Nobcha/ArduinoLCM/Equation＋Circuit.docx

Calibration

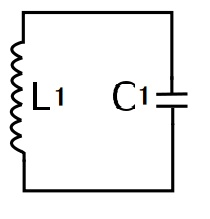
[picture p2: figure]
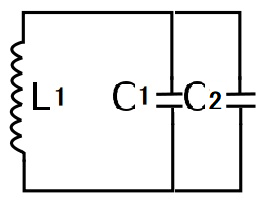
[picture p3: figure]

ｆ１ f2

ｆ1＝1/(, 2π√(Ｌ１・Ｃ１),)

ｆ2＝1/(, 2π√(Ｌ１・（Ｃ１＋Ｃ２）),)

C2：Standard　capacitor、 f1，f2:Measurement value　　　To derive C1 &　L1

Measurement

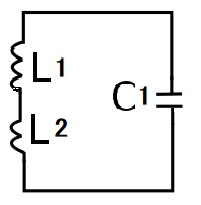
[picture p4: figure]
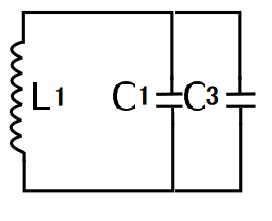
[picture p5: figure]

ｆ31 f32

ｆ31＝1/(, 2π√(Ｌ１・（Ｃ１＋Ｃ3）),) 　　　　　　　　　　ｆ32 ＝1/(, 2π√(（Ｌ１＋Ｌ２）・Ｃ１),)
