Nobcha/ArduinoLCM/equation.pdf

## 1. Calibration

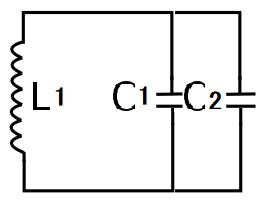
[picture p6: figure]
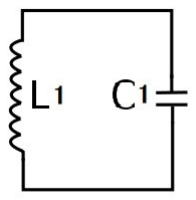
[picture p7: figure]

The basic LC circuit | When calibration, the standard capacitor added.
ｆ１ | f2

ｆ1＝

Ｌ１・Ｃ１

ｆ2＝

Ｌ１・（Ｃ１＋Ｃ２）

C2：Standard capacitor （Precise）、 f1，f2:Measurement value To derive C1 & L1
We got two formulas from above calibration. To solve the simultaneous equations, we get C1 and L1 from C2, f1 and f2.

C1＝

f2∗∗2
(f1∗∗２−f2∗∗２)
C2 | L1＝
ｆ１∗∗２・
After then we will use C1 and L1. They are involved stray capacitance and inductance.

## 2. Measurement

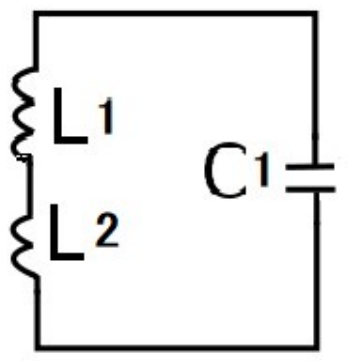
[picture p8: figure]

ｆ31＝ | 1
2πＬ１＋Ｌ２・Ｃ１

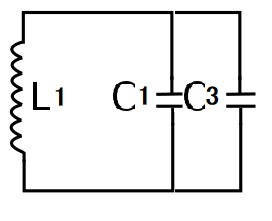
[picture p9: figure]

32 1
2π | 3

The known L1 and C1 and measured f31 and f32 will lead tested L2 and C3 value. L2＝
ｆ1∗∗2
ｆ31∗∗2
− 1・L1 | C3＝
ｆ1∗∗2
ｆ32∗∗2

− 1・C1
