Nobcha/ArduinoLCM/2022-09-08 CASE.jpg

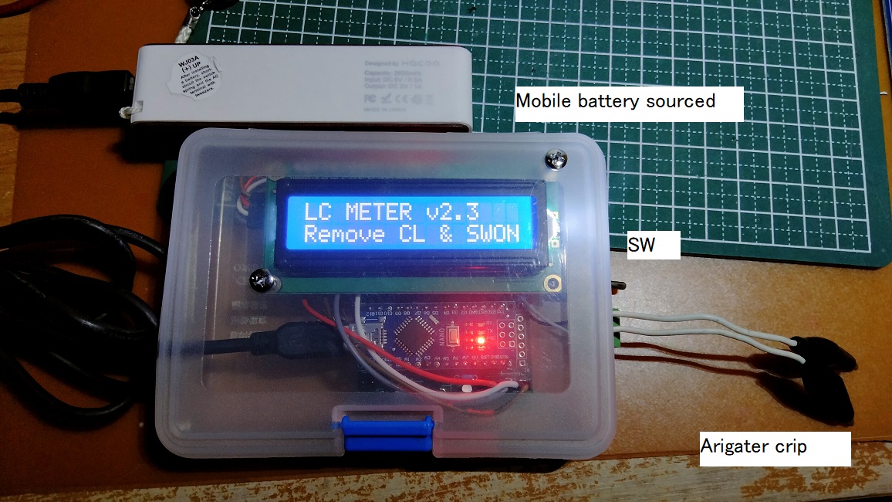
2022-09-08 CASE.jpg
