Nobcha/ArduinoLCM/ArduinoLCM_scm.jpg

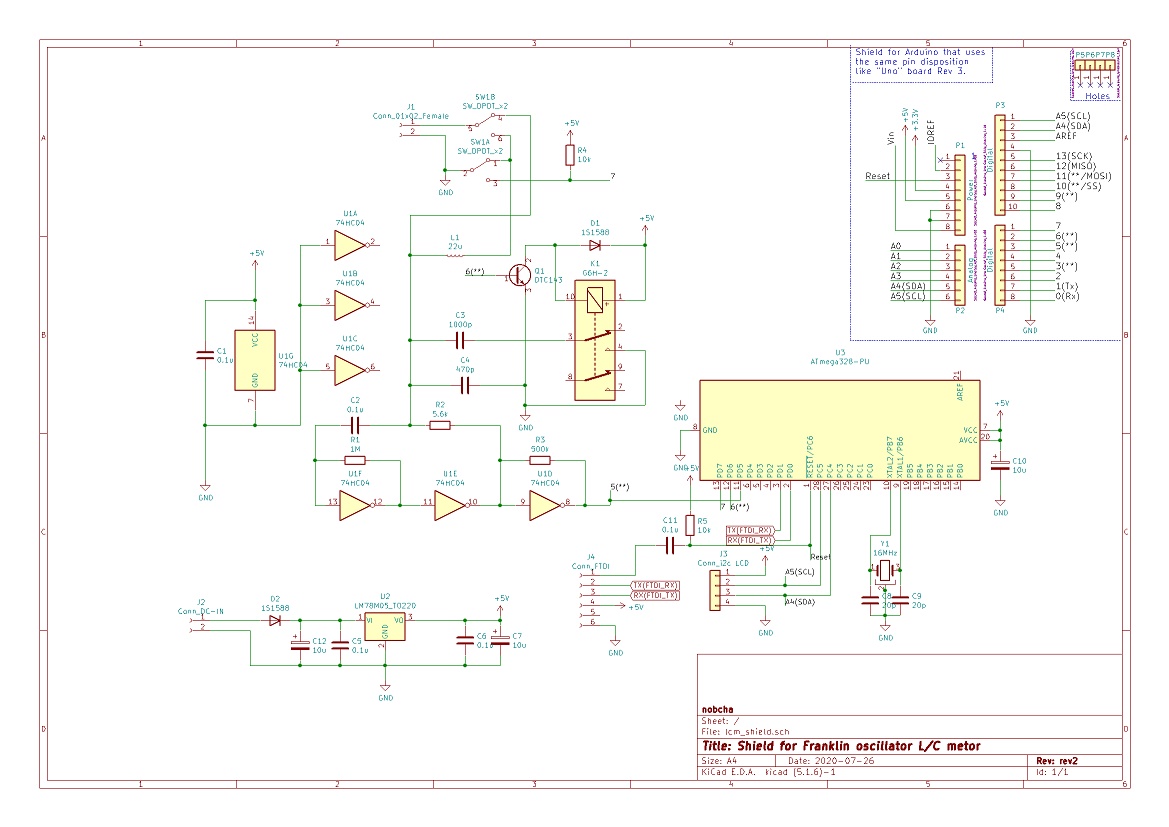
ArduinoLCM_scm.jpg
