Nobcha/ArduinoLCM/LCM_shot.jpg

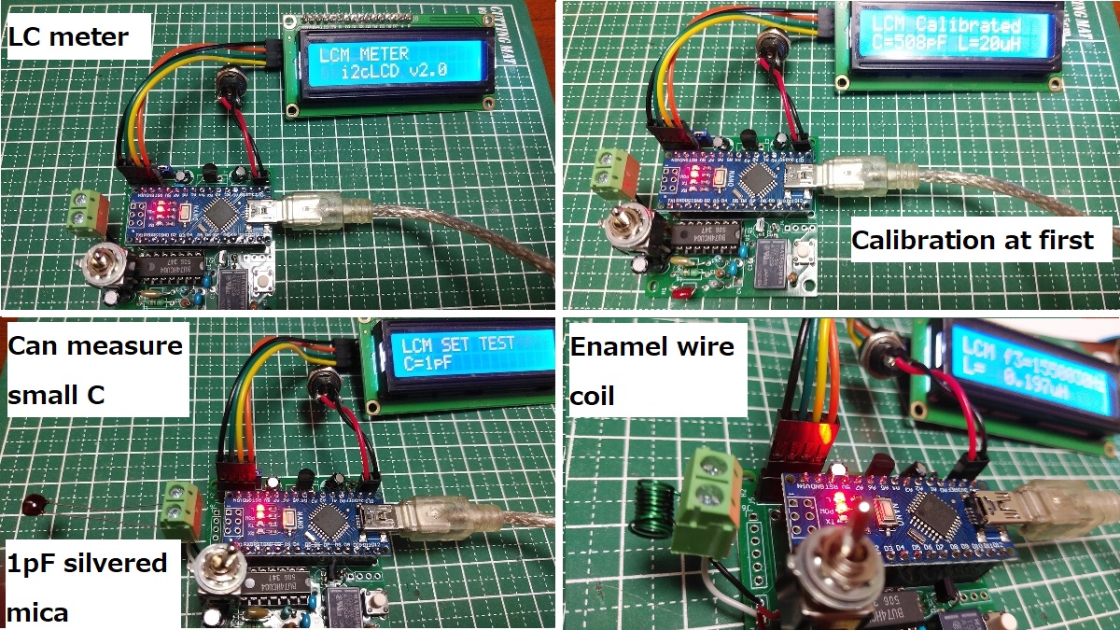
LCM_shot.jpg
