Nobcha/ArduinoLCM/LCM_YOUT_front.jpg

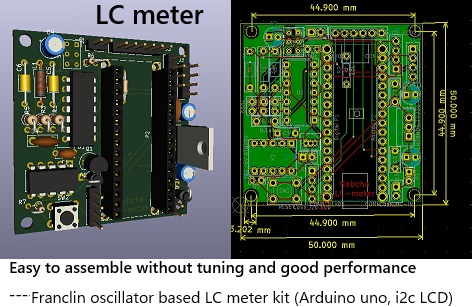
LCM_YOUT_front.jpg
