Nobcha/ArduinoLCM/Parts-list&circuit.docx

There are the circuit diagrams below.

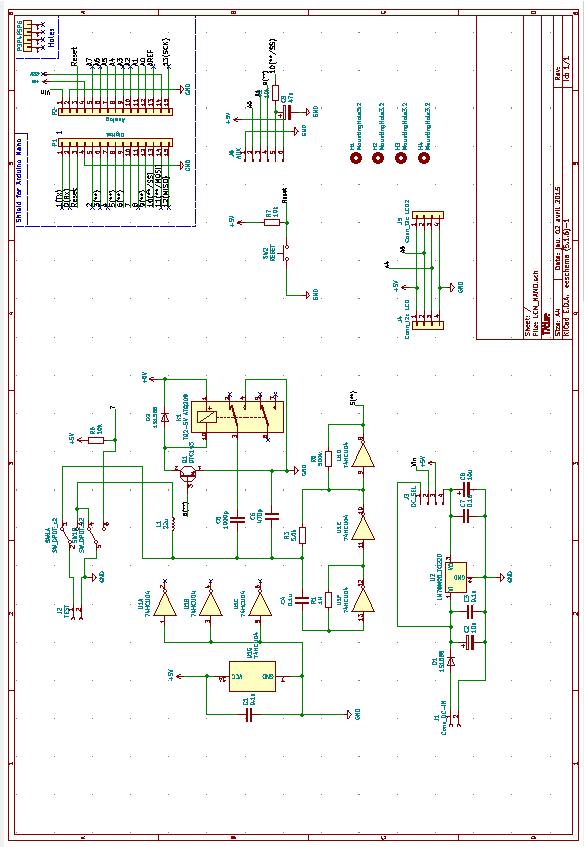
[picture p14: figure]

Parts list

By　nobcha48　AT　gmail.com
