Nobcha/ArduinoLCM/LCM_NANO部品表.pdf

名称 | 部品の寸法など | 分類 | 値/名称 | 部品入手先例
C1 | Capacitor_THT:C_Disc_D5.0mm_W2.5mm_P5.00mm | C | 0.1u | 秋月電子https://akizukidenshi.com/catalog/g/gP-15927/
C2 | Capacitor_THT:CP_Radial_D5.0mm_P2.50mm | CP | 10u | 秋月電子https://akizukidenshi.com/catalog/g/gP-10590/
C3 | Capacitor_THT:C_Disc_D5.0mm_W2.5mm_P5.00mm | C | 0.1u | 秋月電子https://akizukidenshi.com/catalog/g/gP-15927/
C4 | Capacitor_THT:C_Disc_D7.5mm_W2.5mm_P5.00mm | C | 0.1u | 秋月電子https://akizukidenshi.com/catalog/g/gP-15927/
C5 | Capacitor_THT:C_Axial_L3.8mm_D2.6mm_P10.00mm_Horiz ontal | C | 1000p | 秋月電子https://akizukidenshi.com/catalog/g/gP-14587/
C6 | Capacitor_THT:C_Axial_L3.8mm_D2.6mm_P10.00mm_Horiz ontal | C | 470p | 秋月電子https://akizukidenshi.com/catalog/g/gP-14429/
C7 | Capacitor_THT:C_Disc_D7.5mm_W2.5mm_P5.00mm | C | 0.1u | 秋月電子https://akizukidenshi.com/catalog/g/gP-15927/
C8 | Capacitor_THT:CP_Radial_D5.0mm_P2.50mm | CP | 10u | 秋月電子https://akizukidenshi.com/catalog/g/gP-10590/
C9 | Capacitor_THT:CP_Radial_D5.0mm_P2.50mm | CP | 47u | 秋月電子https://akizukidenshi.com/catalog/g/gP-03120/
D1 | Diode_THT:D_A-405_P2.54mm_Vertical_KathodeUp | D | 1S1588 | 秋月電子https://akizukidenshi.com/catalog/g/gI-06191/
D2 | Diode_THT:D_A-405_P2.54mm_Vertical_KathodeUp | D | 1S1588 | 秋月電子https://akizukidenshi.com/catalog/g/gI-06191/
J1 | Connector_PinHeader_2.54mm:PinHeader_1x02_P2.54mm _Vertical | Conn_01x 02_male | Conn_DC-IN | 40ピンのヘッダー例えば https://akizukidenshi.com/catalog/g/gC-00167/を買って、必 要数だけをニッパでカットして使う
J2 | Connector_PinHeader_2.54mm:PinHeader_1x02_P2.54mm _Vertical | Conn_01x 02＿male | TEST
J3 | Connector_PinHeader_2.54mm:PinHeader_1x04_P2.54mm _Vertical | Conn_01x 04_Male | DC_SEL
J4 | Connector_PinHeader_2.54mm:PinHeader_1x04_P2.54mm _Vertical | Conn_01x 04 Conn_i2c LCD
J5 | Connector_PinHeader_2.54mm:PinHeader_1x04_P2.54mm _Vertical | Conn_01x 04 Conn_i2c LCD2
J6 | Connector_PinHeader_2.54mm:PinHeader_1x06_P2.54mm _Vertical | Conn_01x 06_Male | AUX
K1 | Package_DIP:DIP-10_W7.62mm | G6H-2 | TQ2-5V | マルツhttps://www.marutsu.co.jp/pc/i/1528394/
L1 | Inductor_THT:L_Axial_L6.6mm_D2.7mm_P10.16mm_Horizo ntal_Vishay_IM-2 | L_Small | 22uH | 秋月https://akizukidenshi.com/catalog/g/gP-12848/
P1 | Socket_Arduino_Nano:Socket_Strip_Arduino_1x15 | Conn_01x 15 Digital | | 40ピンのヘッダー例えば https://akizukidenshi.com/catalog/g/gC-00167/を買って、必 要数だけをニッパでカットして使う
P2 | Socket_Arduino_Nano:Socket_Strip_Arduino_1x15 | Conn_01x 15 Analog
P3 | Socket_Arduino_Nano:1pin_Nano | Nano | CONN_01X01
P4 | Socket_Arduino_Nano:1pin_Nano | Nano | CONN_01X01
P5 | Socket_Arduino_Nano:1pin_Nano | Nano | CONN_01X01
P6 | Socket_Arduino_Nano:1pin_Nano | Nano | CONN_01X01

Q1 | Package_TO_SOT_THT:TO-92_Inline | Digital TR | DTC143 | 秋月電子https://akizukidenshi.com/catalog/g/gI-12469/
R1 | Resistor_THT:R_Axial_DIN0207_L6.3mm_D2.5mm_P2.54m m_Vertical | R | 1M | 秋月電子https://akizukidenshi.com/catalog/e/erd25s_dT
R2 | Resistor_THT:R_Axial_DIN0204_L3.6mm_D1.6mm_P7.62m m_Horizontal | R | 10k
R3 | Resistor_THT:R_Axial_DIN0207_L6.3mm_D2.5mm_P2.54m m_Vertical | R | 5.6k
R5 | Resistor_THT:R_Axial_DIN0207_L6.3mm_D2.5mm_P2.54m m_Vertical | R | 500k
R6 | Resistor_THT:R_Axial_DIN0204_L3.6mm_D1.6mm_P2.54m m_Vertical | R | 10k
R7 | Resistor_THT:R_Axial_DIN0204_L3.6mm_D1.6mm_P2.54m m_Vertical | R | 10k
SW1 | Button_Switch_THT:SW_NKK_GW12LJP | SW_DPDT _x2 | SW_DPDT_x2 | 秋月電子https://akizukidenshi.com/catalog/g/gP-03775/
SW2 | Button_Switch_THT:SW_PUSH_6mm_H4.3mm | SW_Push | RESET | 秋月電子https://akizukidenshi.com/catalog/g/gP-03647/
U1 | Package_DIP:DIP-14_W7.62mm | 74HC04 | 74HCU04 | 秋月電子https://akizukidenshi.com/catalog/g/gI-11328/
U2 | Package_TO_SOT_THT:TO-220-3_Vertical | LM78M05 _TO220 | LM78M05_TO22 0 秋月電子https://akizukidenshi.com/catalog/g/gI-10996/
| Dupont connectors　　ヂュポンコネクタ、圧着ピン、ハウ ジング、線材 | | | 秋月電子https://akizukidenshi.com/catalog/g/gC-12327/　秋 月電子https://akizukidenshi.com/catalog/g/gC-12151/
| Terminals 陸軍形ターミナル | | | 秋月電子https://akizukidenshi.com/catalog/g/gC-14242/など
CPU | Arduino_Nano
PCB
LCD | i2c IF LCD (PCF8754)
CASE
