Nobcha/ArduinoLCM/LCM_BOM_OLED.jpg

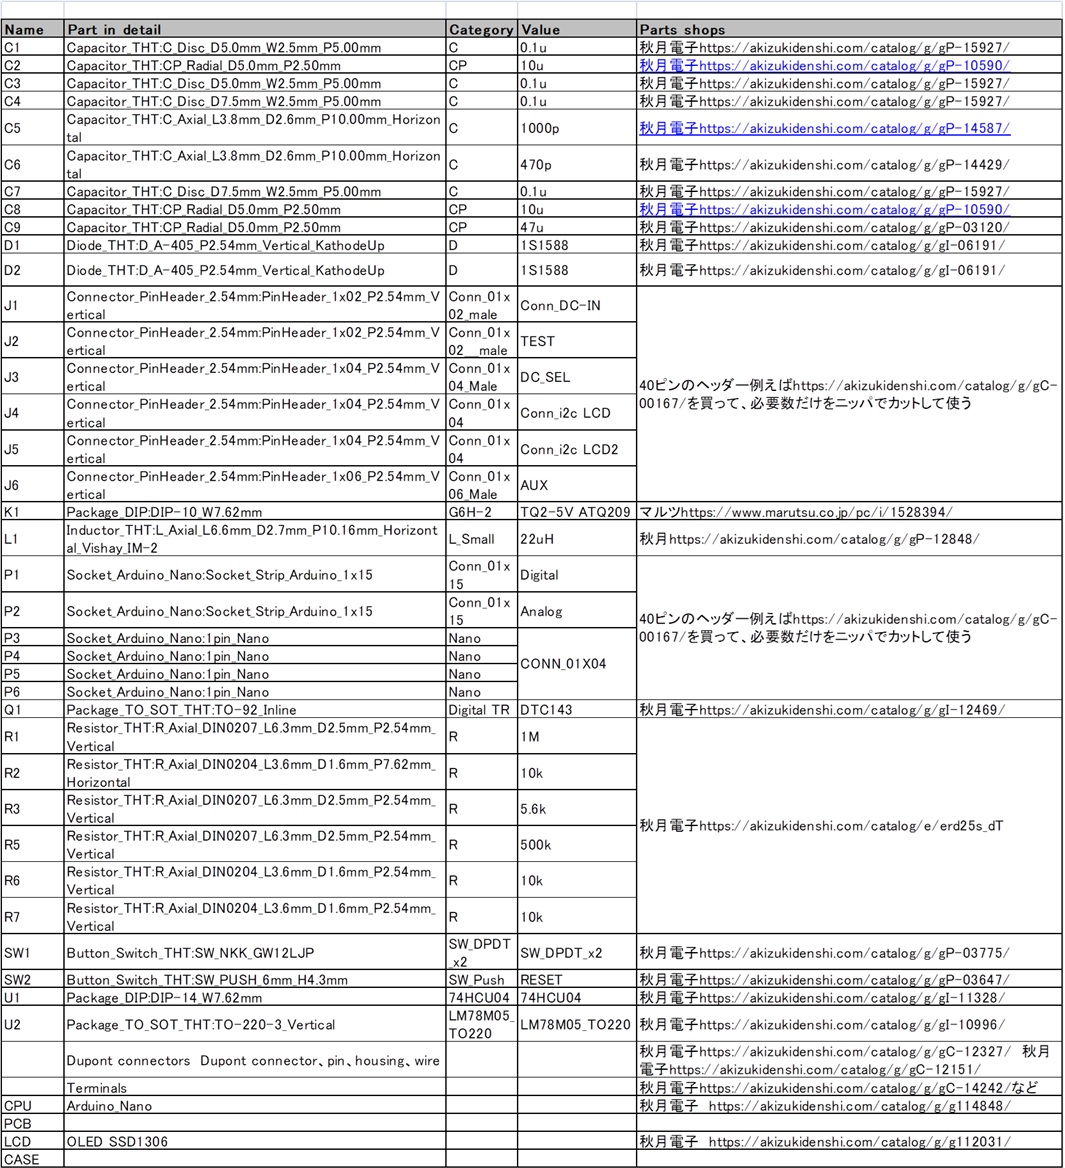
LCM_BOM_OLED.jpg
