Nobcha/ArduinoLCM/LCM6_0.pdf

# フランクリン発振回路を利 用したLCメータの試作

# DIY LC meter used Franclin oscillator

# kpa radio

## トロイダルコアや空芯などの手巻きコイ ルのインダクタンスを確かめるのに便利

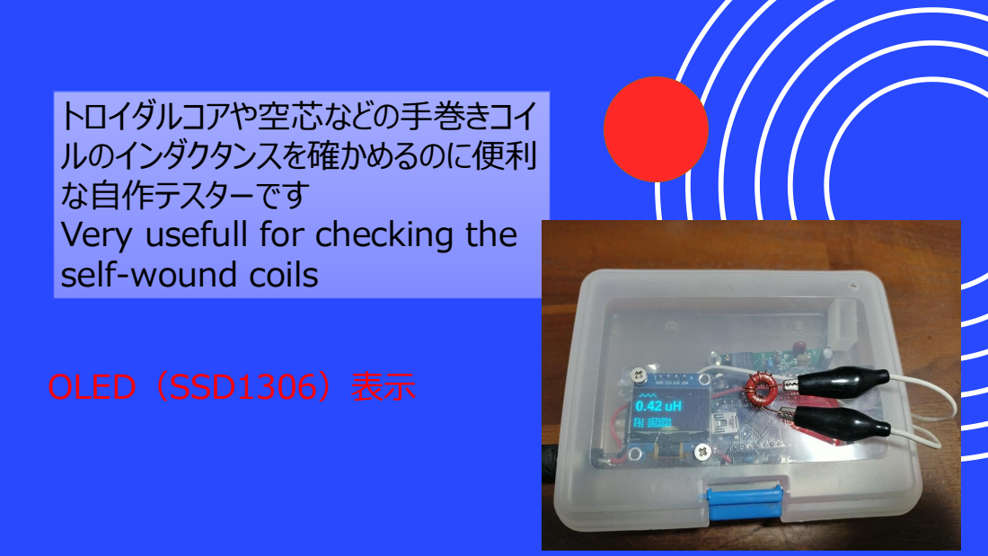
[picture p16: page 2]
OLED（SSD1306）表示

な自作テスターです
Very usefull for checking the
self-wound coils

## 概要：Arduino NANOを 使い、74HCU04によるフラ ンクリン発振回路でLCのイン

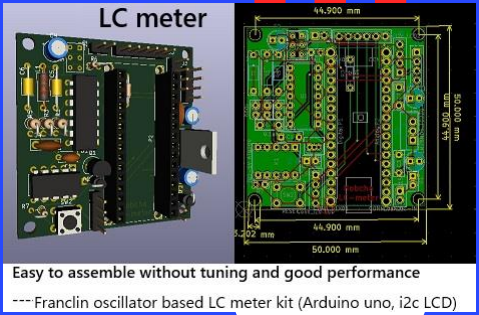
[picture p17: figure]

## ダクタンス、キャパシタンスを 算出します。

使用する部品PARTS：Arduino NANO、
74HCU04、３端子AVR、リレーRelay、
DPSTスイッチ、OLED、抵抗R・コンデンサC・イ ンダクタL類など

# 電源入れてまずはキャリ ブレーション

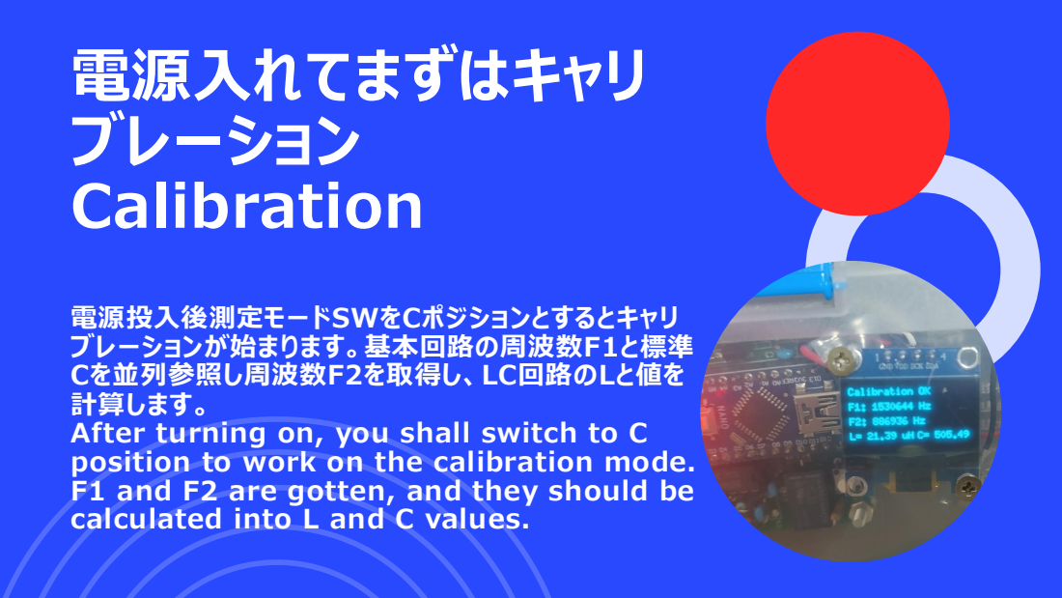
[picture p18: page 4]
Calibration

電源投入後測定モードSWをCポジションとするとキャリ
ブレーションが始まります。基本回路の周波数F1と標準
Cを並列参照し周波数F2を取得し、LC回路のLと値を
計算します。
After turning on, you shall switch to C
position to work on the calibration mode.
F1 and F2 are gotten, and they should be
calculated into L and C values.

## DPSTスイッチでCを選択し、コンデン サをつなぎます。

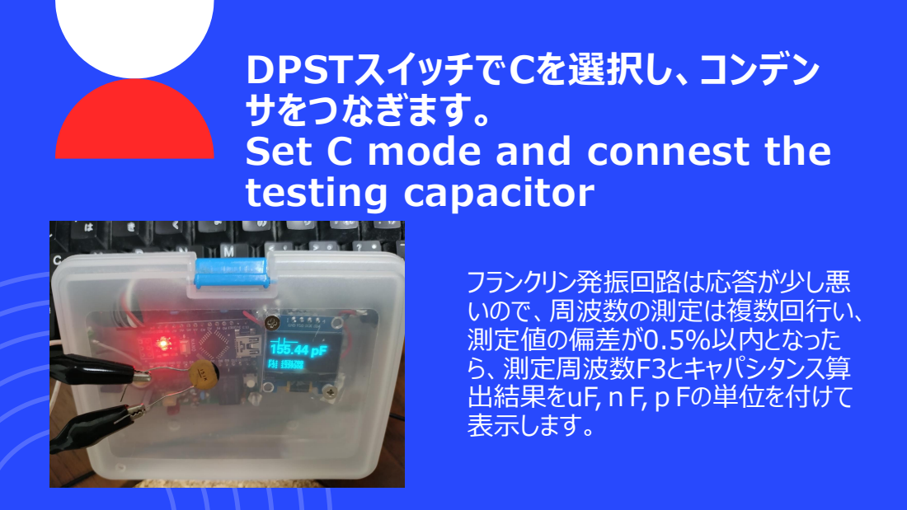
[picture p19: page 5]
フランクリン発振回路は応答が少し悪 いので、周波数の測定は複数回行い、 測定値の偏差が0.5％以内となった ら、測定周波数F3とキャパシタンス算 出結果をuF,ｎF,ｐFの単位を付けて 表示します。

Set C mode and connest the
testing capacitor

## DPSTスイッチでLCを選択し、インダク タをつなぎます To select L mode

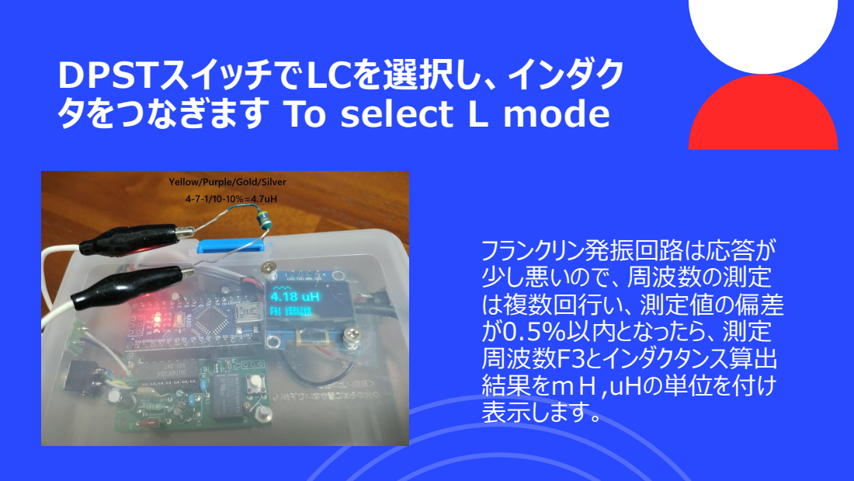
[picture p20: page 6]
フランクリン発振回路は応答が 少し悪いので、周波数の測定 は複数回行い、測定値の偏差 が0.5％以内となったら、測定 周波数F3とインダクタンス算出 結果をｍＨ,uHの単位を付け 表示します。

## 追試用のデータはGITHUBにあります。

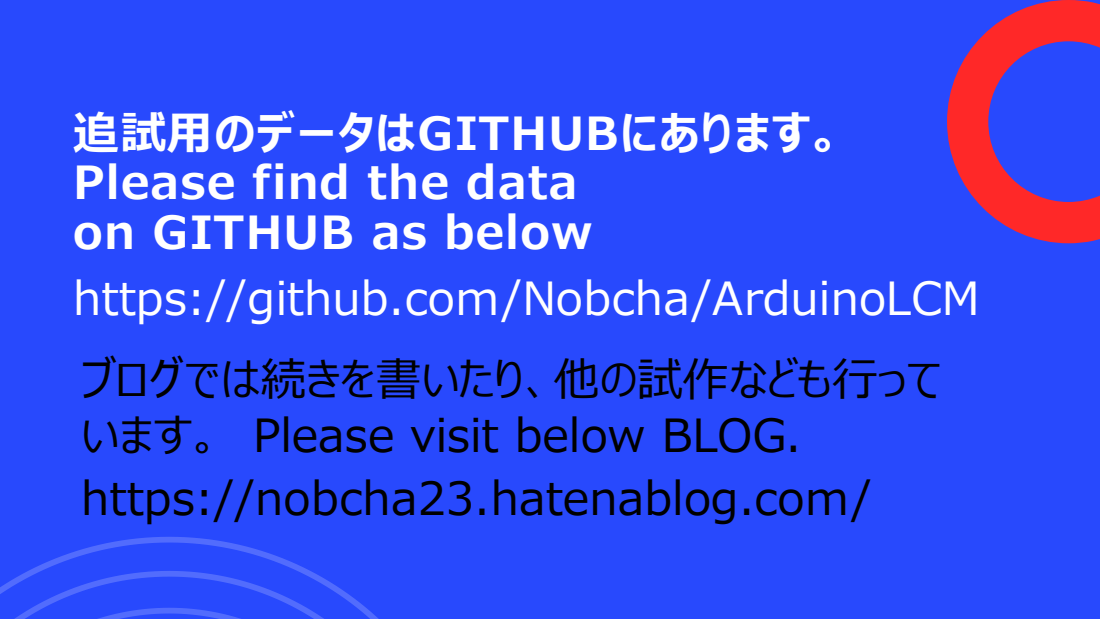
[picture p21: page 7]

Please find the data
on GITHUB as below
https://github.com/Nobcha/ArduinoLCM
ブログでは続きを書いたり、他の試作なども行って
います。 Please visit below BLOG.
https://nobcha23.hatenablog.com/

# ありがとうございました

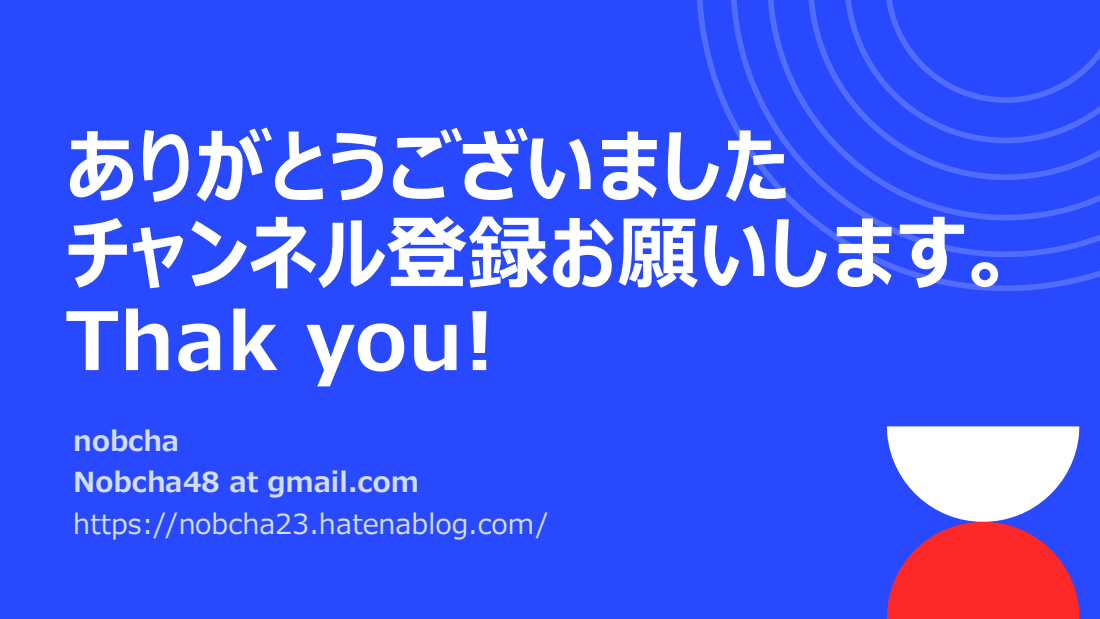
[picture p22: page 8]
チャンネル登録お願いします。 Thak you!

nobcha
Nobcha48 at gmail.com
https://nobcha23.hatenablog.com/
