Nobcha/ArduinoLCM/(commit log)

2023-03-25 Improved
    1. フランクリン発振安定化待ちのタイミングを追加。（シミュレーションでも気が付いたのですが、この発振器は発振周波数が安定するのに時間がかかります）
    To add wait for stabilization of Franclin oscillator.
    2.L／C接続要求メッセージの改良。
    To improve the message.
    3. nH, uH, mH / pF, nF, uF 表記。sprintfのfloat未対応対策でとしてdtostrに替え3.1桁表示とした。
    To display the result with 3.1 column of nH, uH, mH / pF, nF, uF.
    4.F3表示が邪魔だとのことで、D８をGNDにつなぐとF３表示をやめます。
    When D8 is Low, to stop displaying F3.
    [LCM2_42.ino]
2023-08-26 Update README.md
    I designed PCB with Arduino nano and improved sketch a V2.
2023-08-26 LCM with Arduino nano
    Gerber data and BOM in English and Japanese.
2024-10-13 PCB layout
2025-06-26 OLED display version of 6
    To change the 1602A LCD to the OLED(SSD1306 128x64) and to wait stabilized for oscillator.
    [lc_meter_v_3.ino]
2025-11-02 The circuit diagram
    Add
2025-11-02 LCD 6.0 OLED version
    New BOM for V6 of OLED
2026-02-13 Update README with additional links
    Added links to the lc_meter_v_64.ino file and a blog post. I changed the display from LCD1602 to OLED SSD1602.
